JadhavLab/SpikeGadgets_OpenEphys_Drive/README.md

# SpikeGadgets_OpenEphys_Drive
A tetrode hyper drive adapted from open ephys to work with spikegadgets
