JadhavLab/SpikeGadgets_OpenEphys_Drive/Spikegadgets 256 EIB parts+screws/OpenEphysMap.pdf

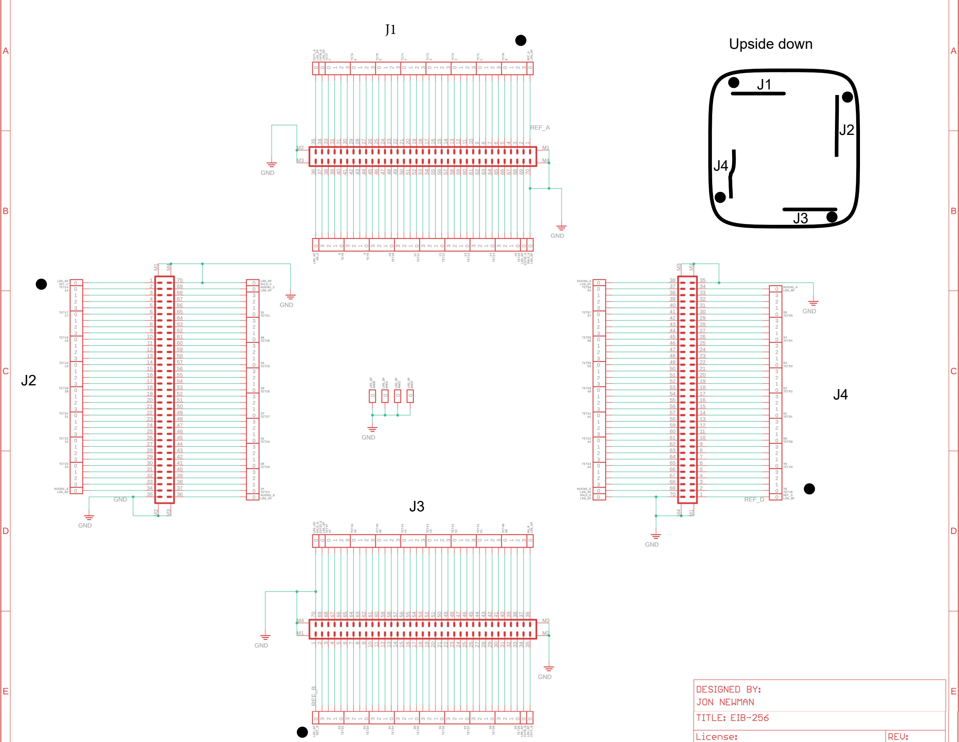
[picture p1: page 1]

J1

J4

J2

J3

Upside down

J1

J2

J3

J4
