JadhavLab/SpikeGadgets_OpenEphys_Drive/Spikegadgets 256 EIB parts+screws/256ch NOT channels.PNG

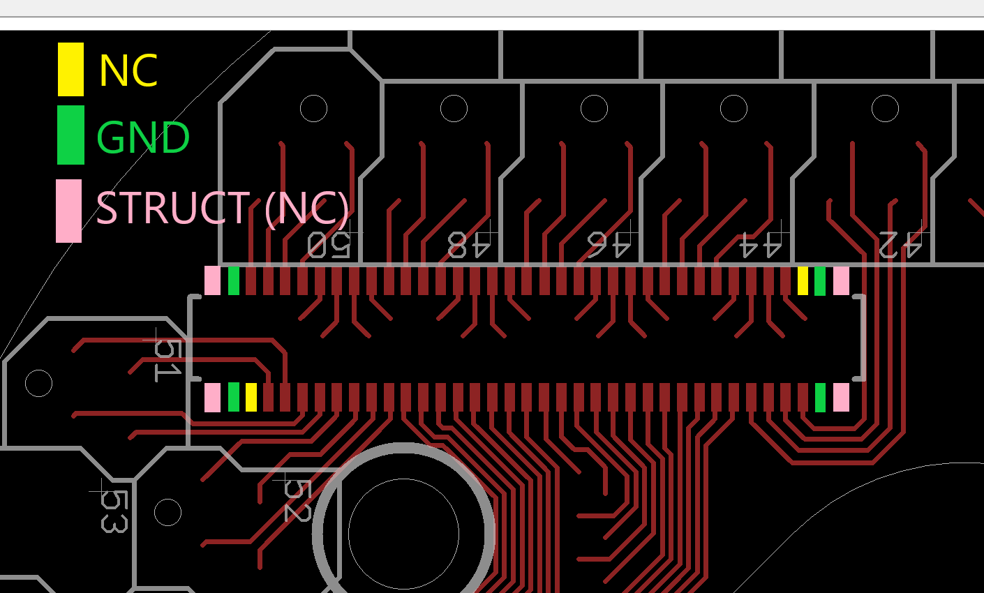
Spikegadgets 256 EIB parts+screws/256ch NOT channels.PNG
