JadhavLab/SpikeGadgets_OpenEphys_Drive/Spikegadgets 256 EIB parts+screws/OE drive pads.png

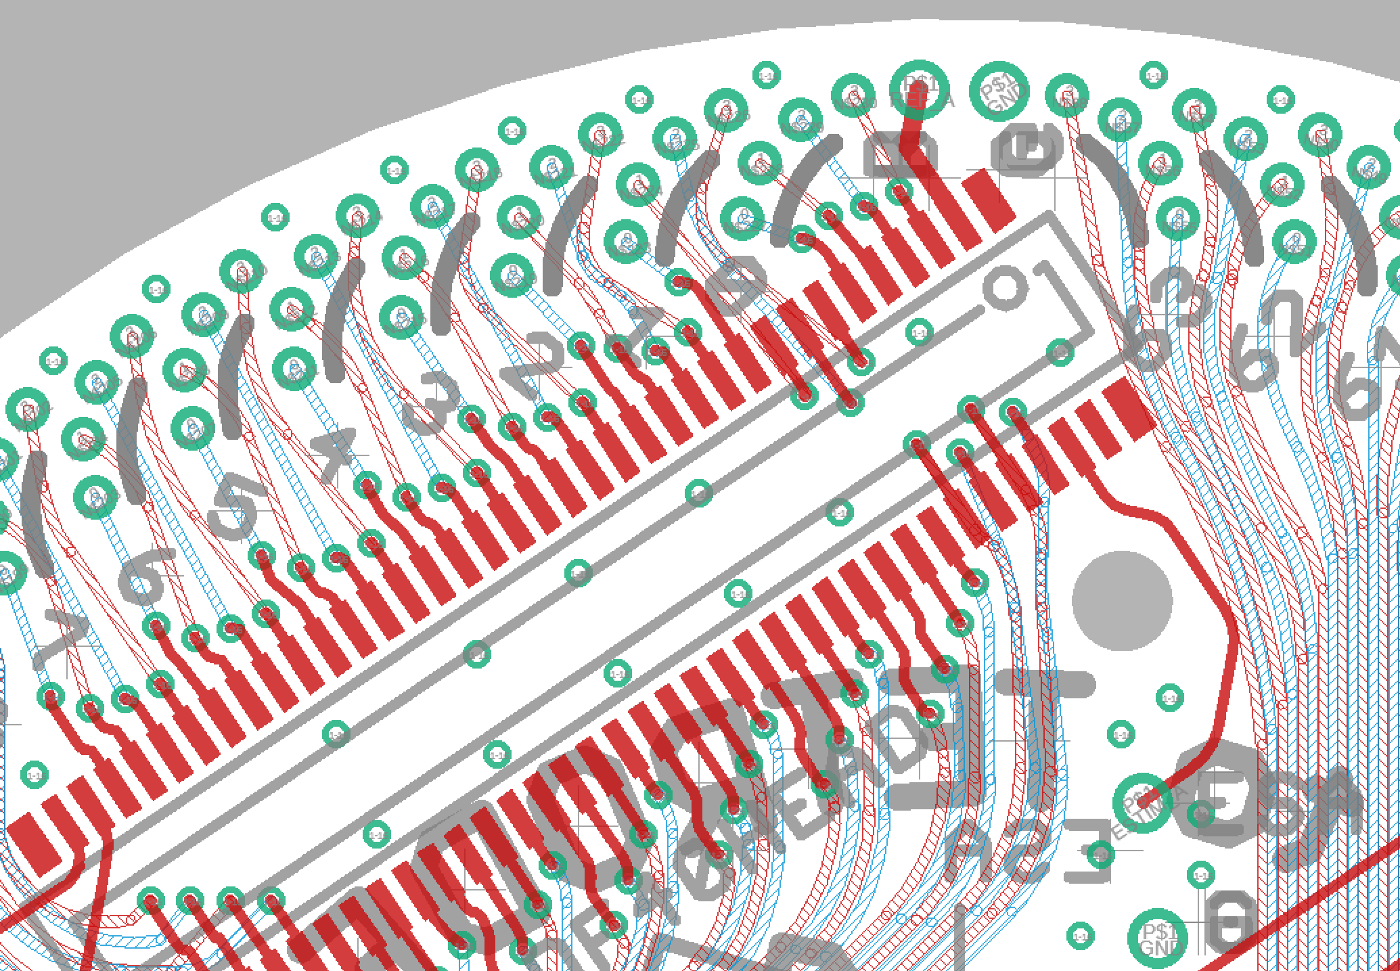
Spikegadgets 256 EIB parts+screws/OE drive pads.png
