JadhavLab/SpikeGadgets_OpenEphys_Drive/Spikegadgets 256 EIB parts+screws/OpenEphysMap.tif

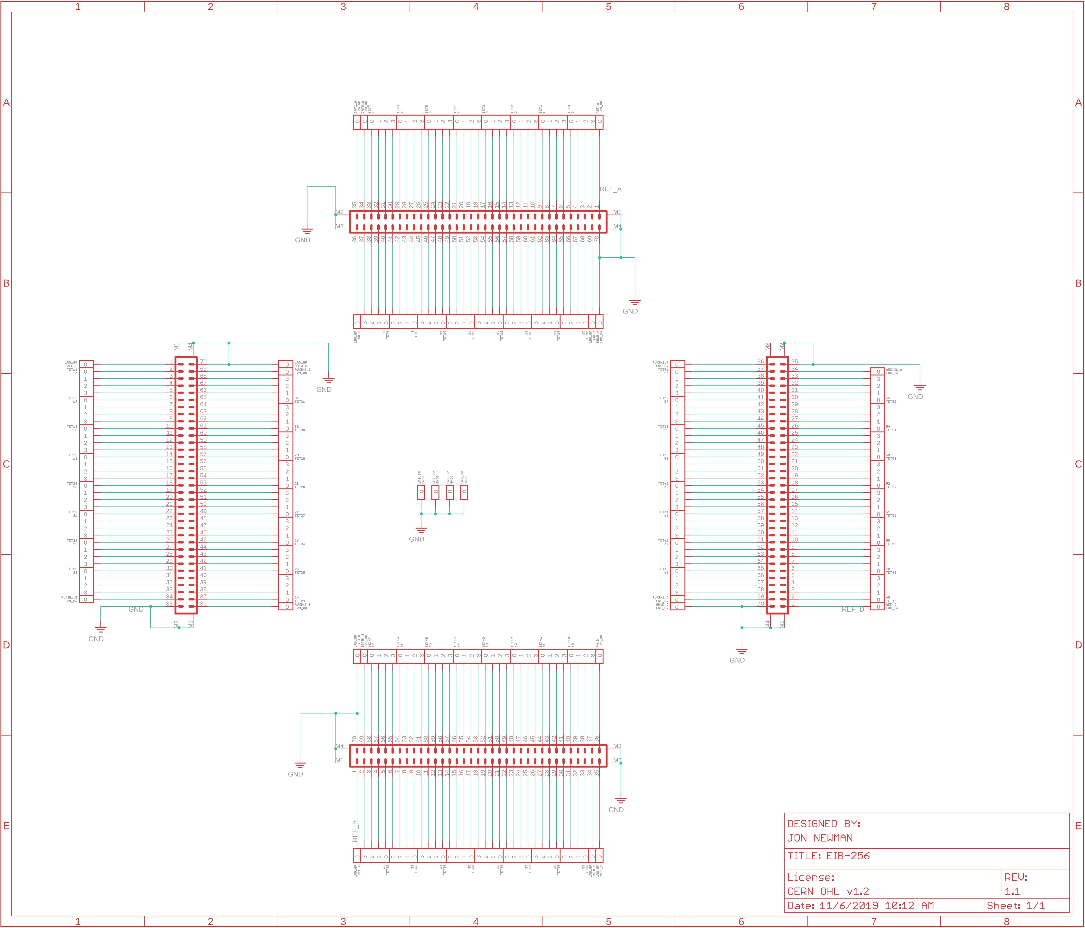
Spikegadgets 256 EIB parts+screws/OpenEphysMap.tif
