JadhavLab/SpikeGadgets_OpenEphys_Drive/Spikegadgets 256 EIB parts+screws/SpikeGadgets256.jpg

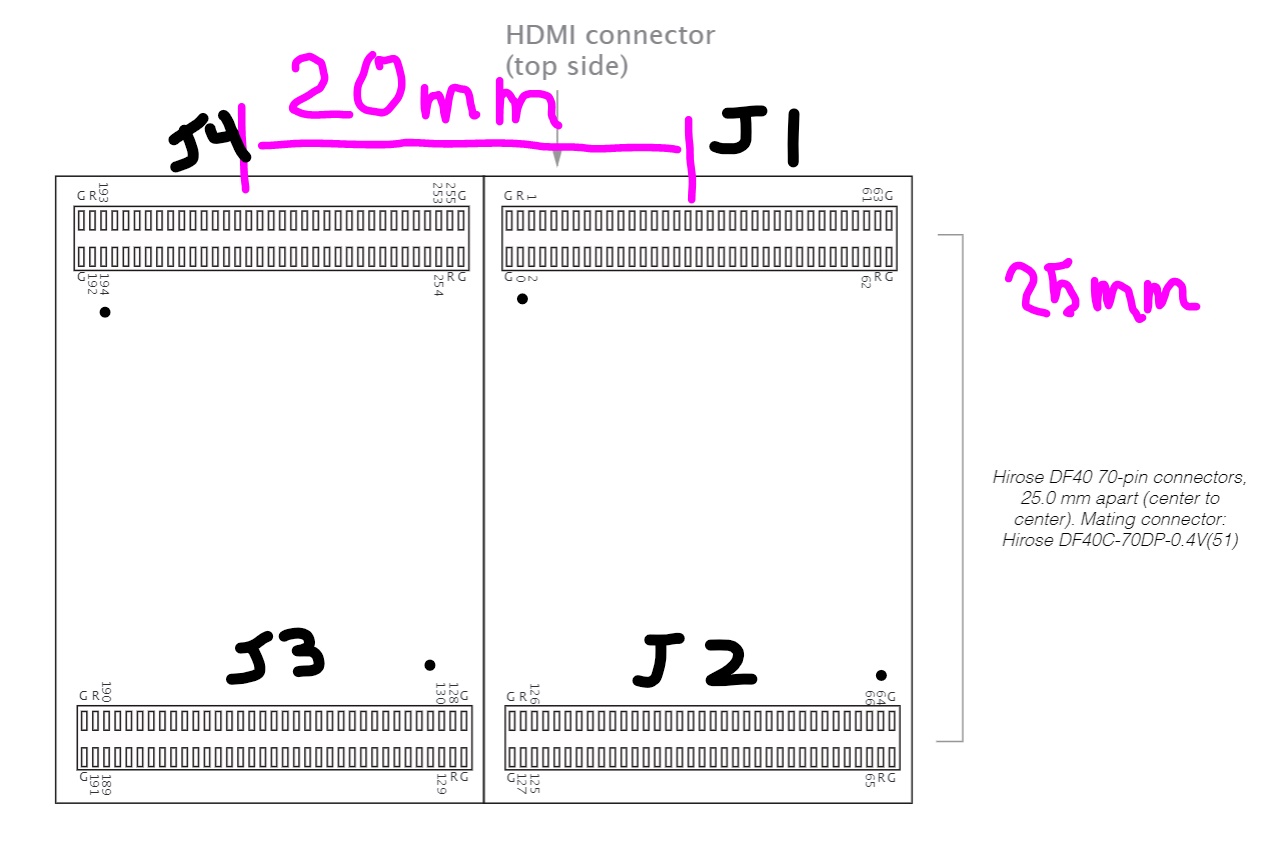
Spikegadgets 256 EIB parts+screws/SpikeGadgets256.jpg
