JadhavLab/SpikeGadgets_OpenEphys_Drive/SG_Drive_Jig_Assembly/Drive/Drive_body_v4.SLDPRT

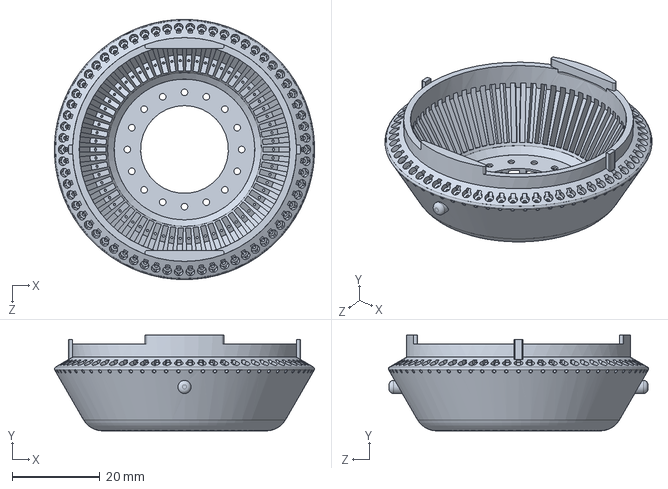
[picture p6: CAD file, 2020-12-02]
SG_Drive_Jig_Assembly/Drive/Drive_body_v4.SLDPRT
59.2 x 21.8 x 59.3 mm
