JadhavLab/SpikeGadgets_OpenEphys_Drive/SG_Drive_Jig_Assembly/Jig/2020_12_14_stls/M2_Hex_Knob.STL

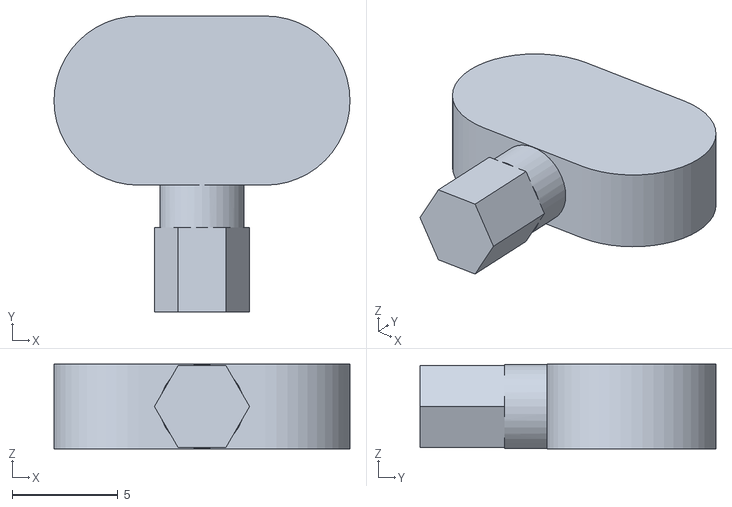
[picture p7: CAD file, 2020-12-14]
SG_Drive_Jig_Assembly/Jig/2020_12_14_stls/M2_Hex_Knob.STL
14.0 x 14.0 x 4.00
