JadhavLab/SpikeGadgets_OpenEphys_Drive/SG_Drive_Jig_Assembly/Jig/eib_holder_top.SLDPRT

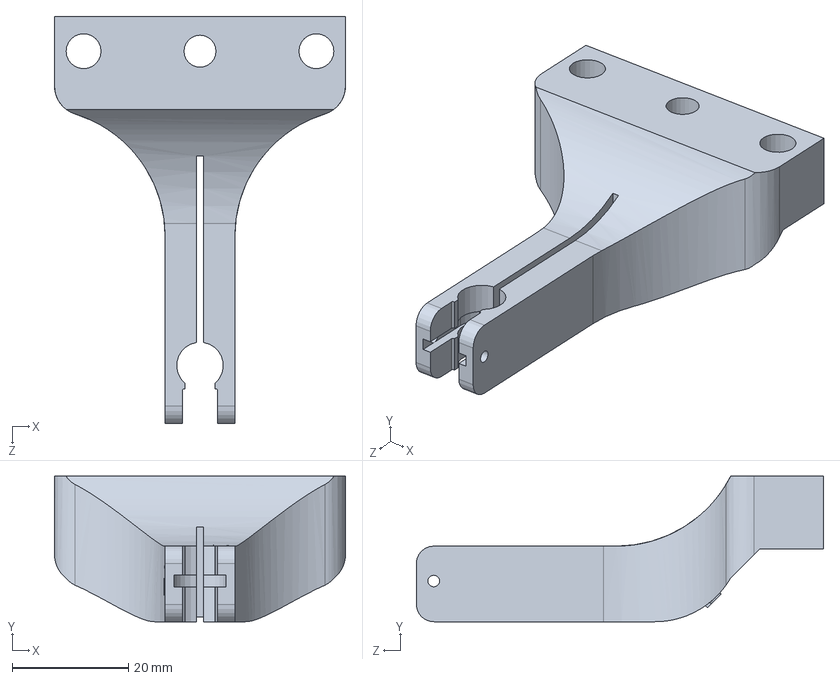
[picture p8: CAD file, 2020-12-02]
SG_Drive_Jig_Assembly/Jig/eib_holder_top.SLDPRT
50.0 x 25.0 x 70.0 mm
