JadhavLab/SpikeGadgets_OpenEphys_Drive/SG_Drive_Jig_Assembly/Jig/Standard Parts ie Resources/SpikeGadgets_256_EIB.SLDPRT

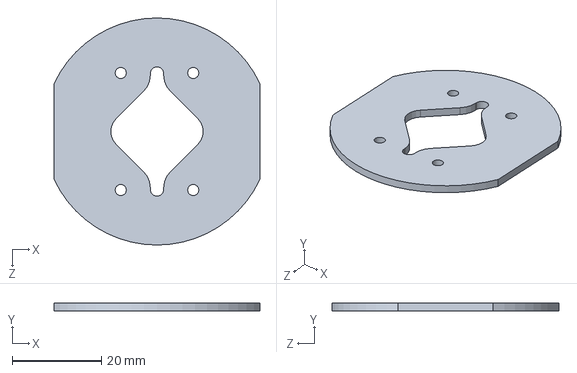
[picture p9: CAD file, 2020-12-02]
SG_Drive_Jig_Assembly/Jig/Standard Parts ie Resources/SpikeGadgets_256_EIB.SLDPRT
46.2 x 1.75 x 50.9 mm
