JadhavLab/SpikeGadgets_OpenEphys_Drive/Tetrode Spooler/Spool.SLDPRT

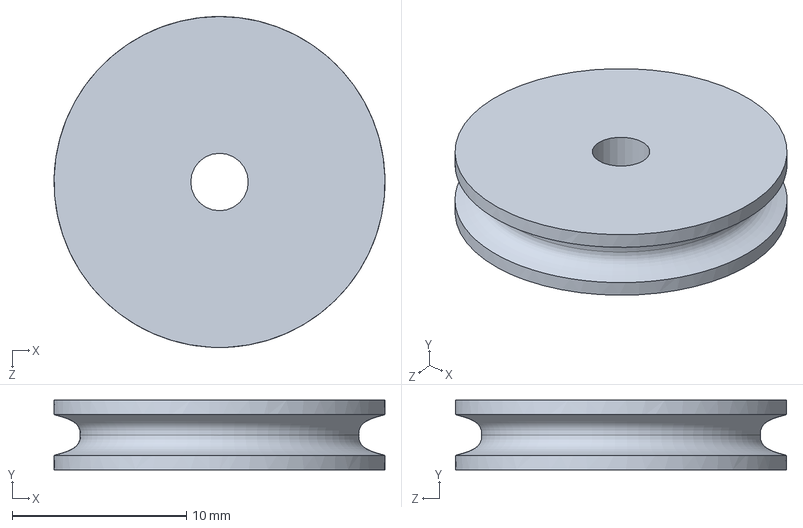
[picture p10: CAD file, 2020-12-02]
Tetrode Spooler/Spool.SLDPRT
19.0 x 4.00 x 19.0 mm
