JadhavLab/SpikeGadgets_OpenEphys_Drive/SG_Drive_Jig_Assembly/Drive/drive_shuttle_JB_pallet-grey-v2.SLDPRT

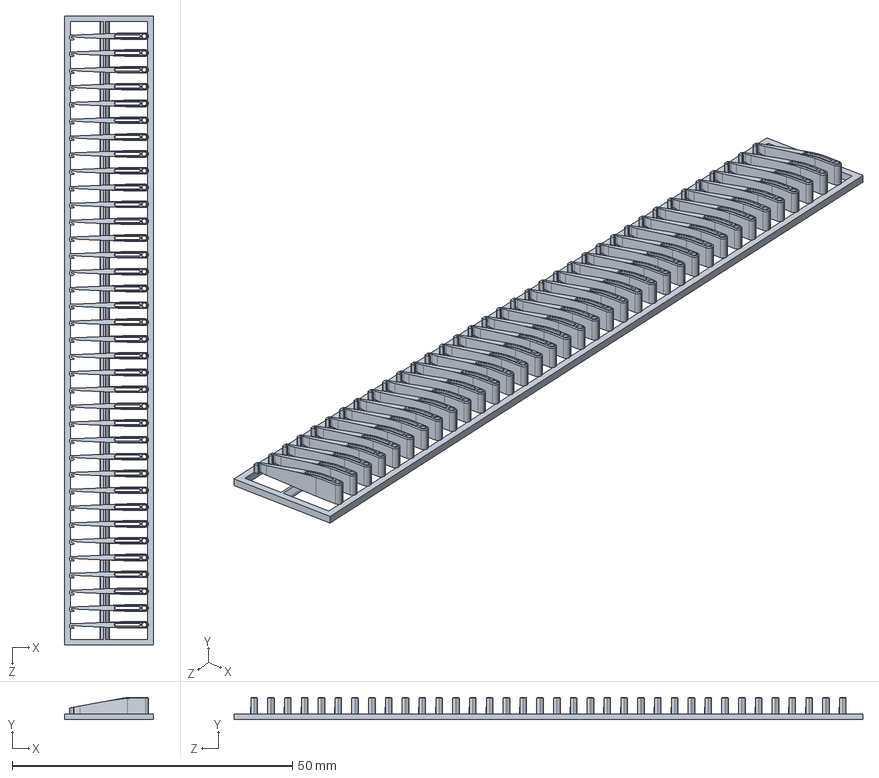
[picture p11: CAD file, 2020-12-02]
SG_Drive_Jig_Assembly/Drive/drive_shuttle_JB_pallet-grey-v2.SLDPRT
15.8 x 4.00 x 112.2 mm
