JadhavLab/SpikeGadgets_OpenEphys_Drive/SG_Drive_Jig_Assembly/Guides/drive-guide-HPC-PFC_v2.1.SLDPRT

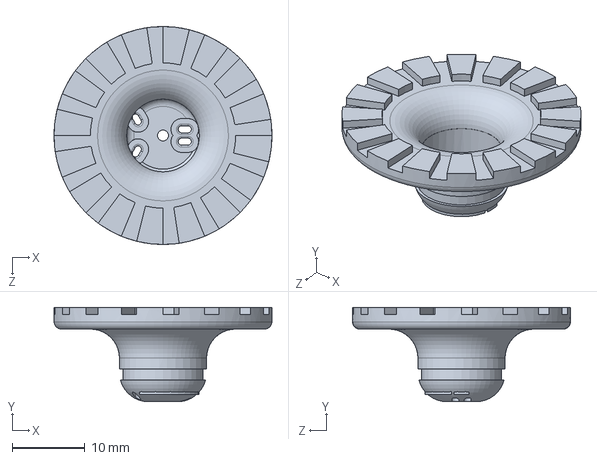
[picture p12: CAD file, 2020-12-02]
SG_Drive_Jig_Assembly/Guides/drive-guide-HPC-PFC_v2.1.SLDPRT
30.0 x 13.0 x 30.0 mm
