JadhavLab/SpikeGadgets_OpenEphys_Drive/SG_Drive_Jig_Assembly/Jig/2020_12_14_stls/drive_holder_inner.STL

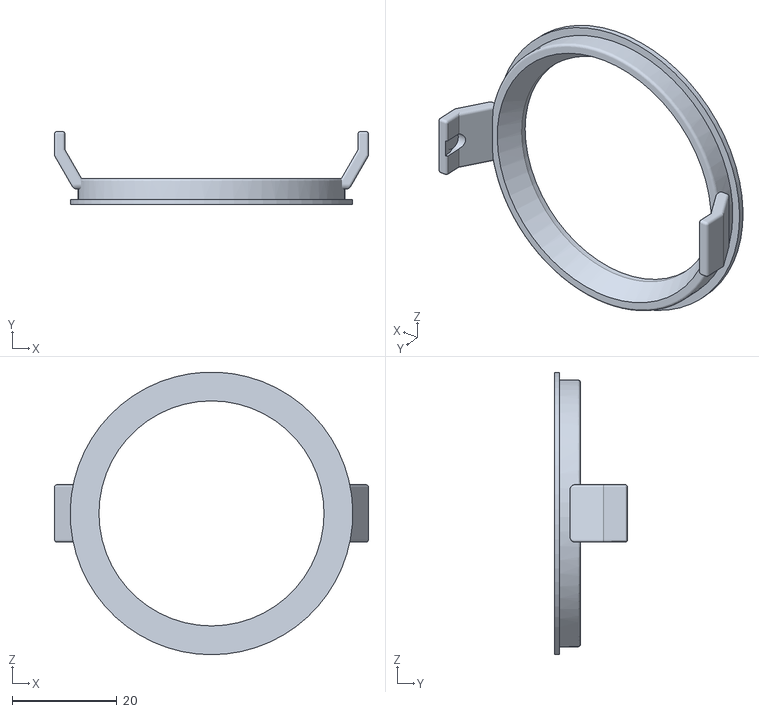
[picture p13: CAD file, 2020-12-14]
SG_Drive_Jig_Assembly/Jig/2020_12_14_stls/drive_holder_inner.STL
60.0 x 14.0 x 54.0
