JadhavLab/SpikeGadgets_OpenEphys_Drive/SG_Drive_Jig_Assembly/Jig/drive_holder_outer_ring.SLDPRT

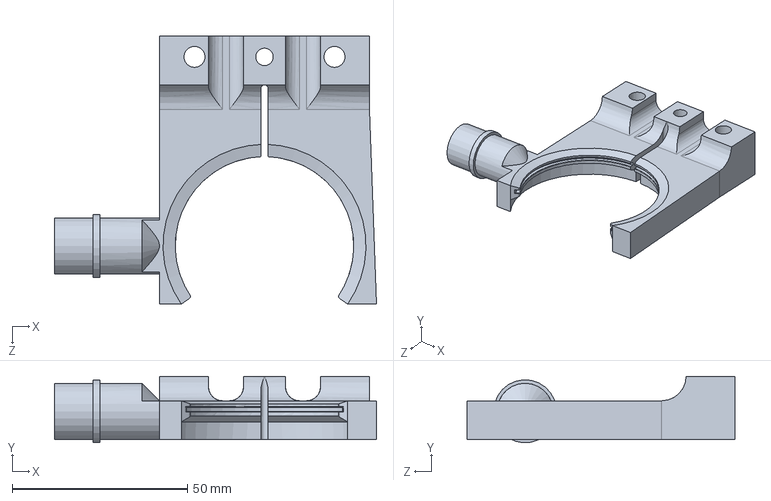
[picture p14: CAD file, 2020-12-02]
SG_Drive_Jig_Assembly/Jig/drive_holder_outer_ring.SLDPRT
92.0 x 19.0 x 76.6 mm
