JadhavLab/SpikeGadgets_OpenEphys_Drive/SG_Drive_Jig_Assembly/Jig/Standard Parts ie Resources/80mm_6mm_dowel.SLDPRT

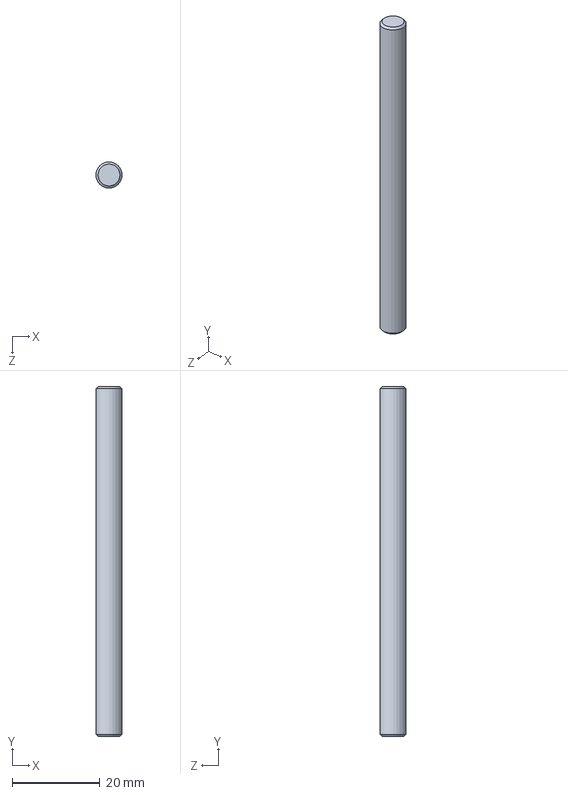
[picture p15: CAD file, 2020-12-02]
SG_Drive_Jig_Assembly/Jig/Standard Parts ie Resources/80mm_6mm_dowel.SLDPRT
6.00 x 80.0 x 6.00 mm
