JadhavLab/SpikeGadgets_OpenEphys_Drive/Tetrode Spooler/Spool_extendedSize.SLDPRT

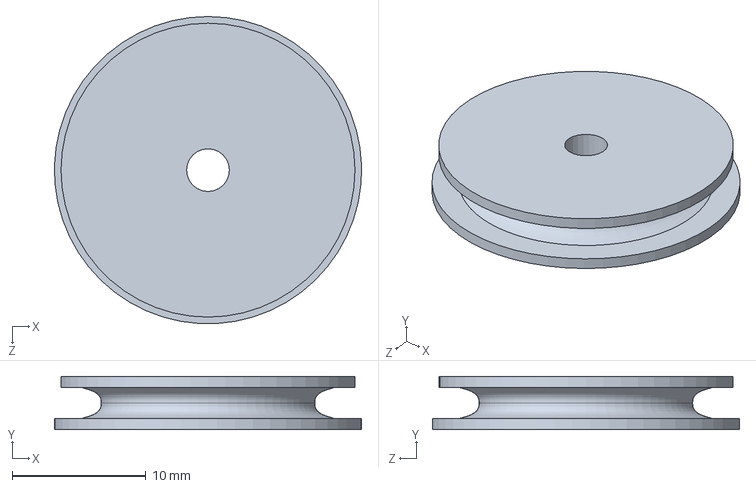
[picture p16: CAD file, 2020-12-02]
Tetrode Spooler/Spool_extendedSize.SLDPRT
23.0 x 4.00 x 23.0 mm
