JadhavLab/SpikeGadgets_OpenEphys_Drive/SG_Drive_Jig_Assembly/Jig/2020_12_14_stls/base.STL

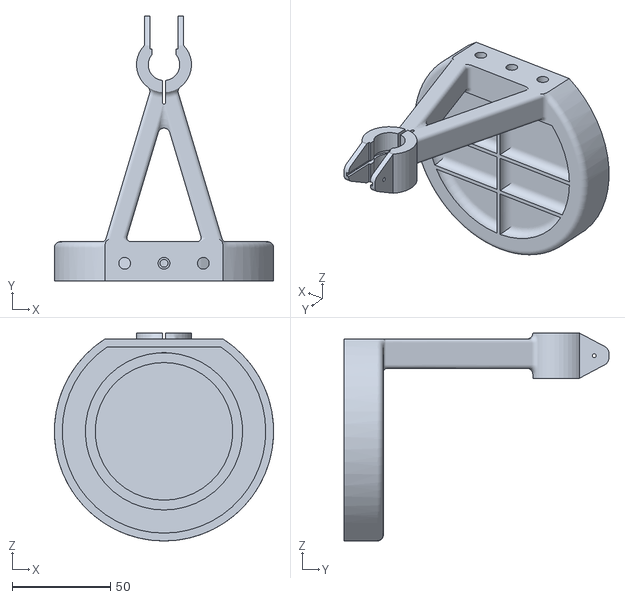
[picture p17: CAD file, 2020-12-14]
SG_Drive_Jig_Assembly/Jig/2020_12_14_stls/base.STL
111.5 x 134.8 x 105.8
