JadhavLab/SpikeGadgets_OpenEphys_Drive/SG_Drive_Jig_Assembly/Jig/EIB_Holder_bottom.SLDPRT

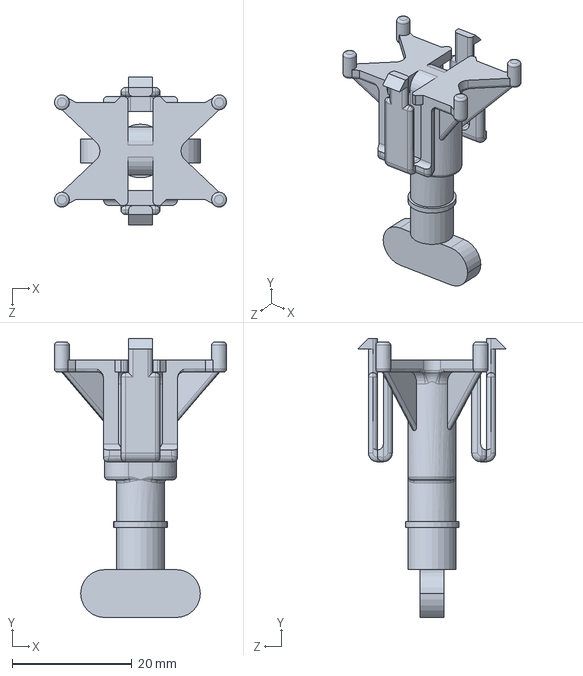
[picture p18: CAD file, 2020-12-02]
SG_Drive_Jig_Assembly/Jig/EIB_Holder_bottom.SLDPRT
28.8 x 46.6 x 24.8 mm
