JadhavLab/SpikeGadgets_OpenEphys_Drive/Tetrode Spooler/Spool_regularSize.STL

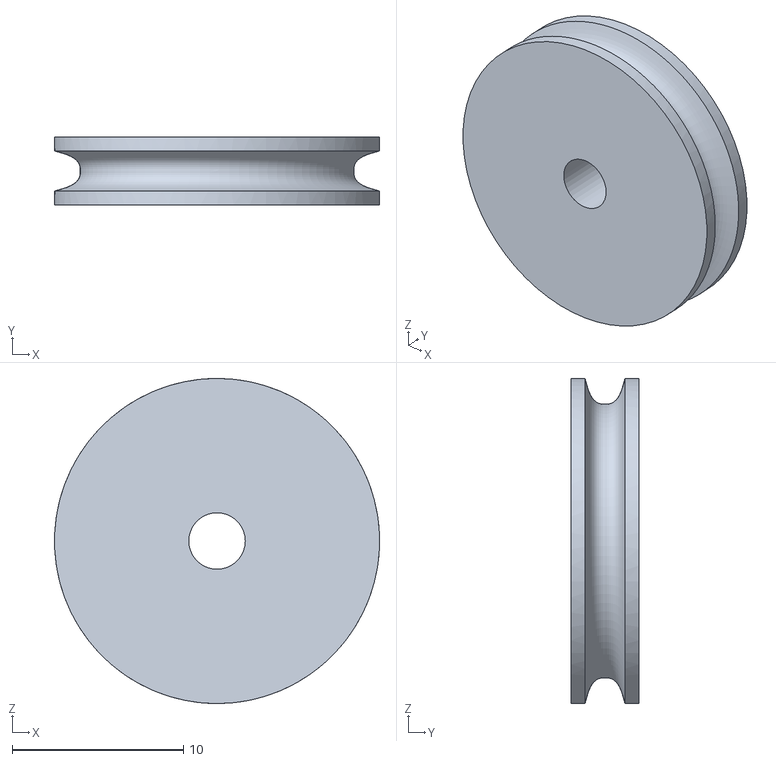
[picture p19: CAD file, 2020-12-02]
Tetrode Spooler/Spool_regularSize.STL
19.0 x 4.00 x 19.0
