JadhavLab/SpikeGadgets_OpenEphys_Drive/(list of files, cad)

Other CAD files:
SG_Drive_Jig_Assembly/Jig/Standard Parts ie Resources/M2_Hex_Knob.SLDPRT
SG_Drive_Jig_Assembly/Jig/2020_12_14_stls/drive_holder_outer_ring.STL
SG_Drive_Jig_Assembly/Jig/drive_holder_inner.SLDPRT
SG_Drive_Jig_Assembly/Jig/2020_12_14_stls/EIB_Holder_bottom.STL
SG_Drive_Jig_Assembly/Jig/base.SLDPRT
SG_Drive_Jig_Assembly/Jig/2020_12_14_stls/eib_holder_top.STL
SG_Drive_Jig_Assembly/Drive/Old Drive and shuttle versions/drive_body_v3.SLDPRT
SG_Drive_Jig_Assembly/Drive/Old Drive and shuttle versions/drive_shuttle_JB_pallet-grey.SLDPRT
SG_Drive_Jig_Assembly/Drive/Old Drive and shuttle versions/rat_drive_shuttle_JB_pallet.SLDPRT
SG_Drive_Jig_Assembly/Guides/drive-guide-HPC-PFC_v2.SLDPRT
SG_Drive_Jig_Assembly/Jig/Standard Parts ie Resources/91290A201_BLACK-OXIDE CLASS 12.9 SOCKET HEAD CAP SCREW.SLDPRT
SG_Drive_Jig_Assembly/Jig/Standard Parts ie Resources/91292A835_TYPE 18-8 SS SOCKET HEAD CAP SCREW.SLDPRT
SG_Drive_Jig_Assembly/Jig/Standard Parts ie Resources/Slanted-threaded-sholder screw.SLDPRT
Tetrode Spooler/Spool_extendedSize.STL
