JadhavLab/SpikeGadgets_OpenEphys_Drive/Spikegadgets 256 EIB parts+screws/df40-70dp-0.4v(51) plug.pdf

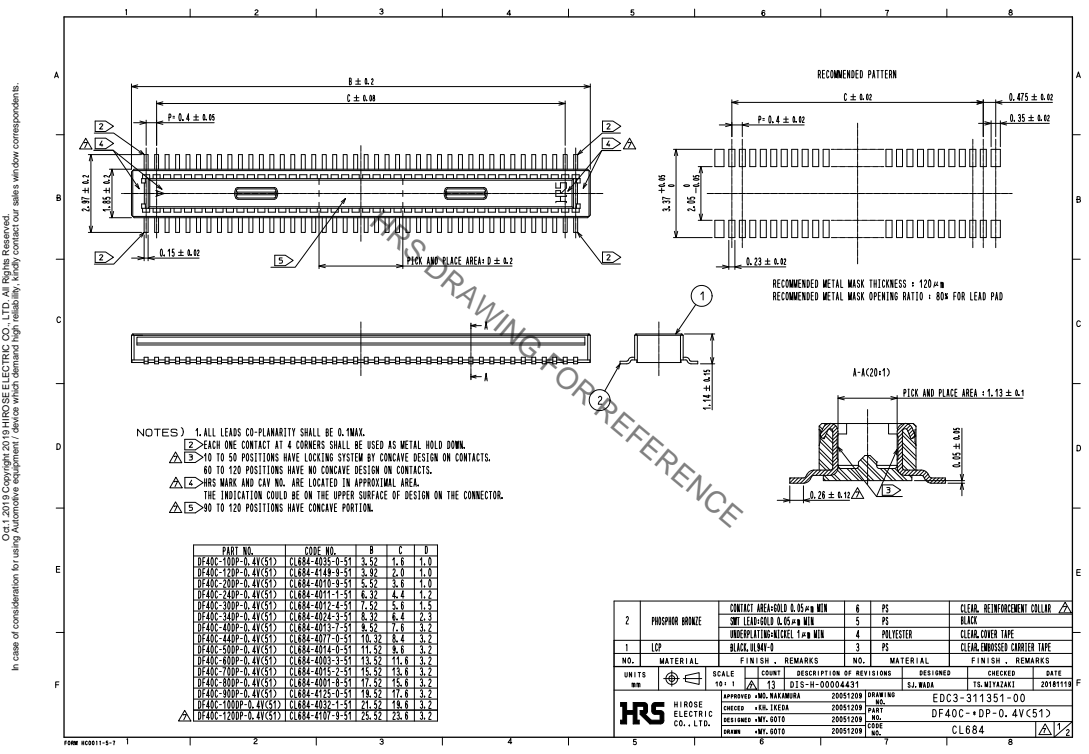
[picture p20: page 1]

HRS DRAWING FOR REFERENCE

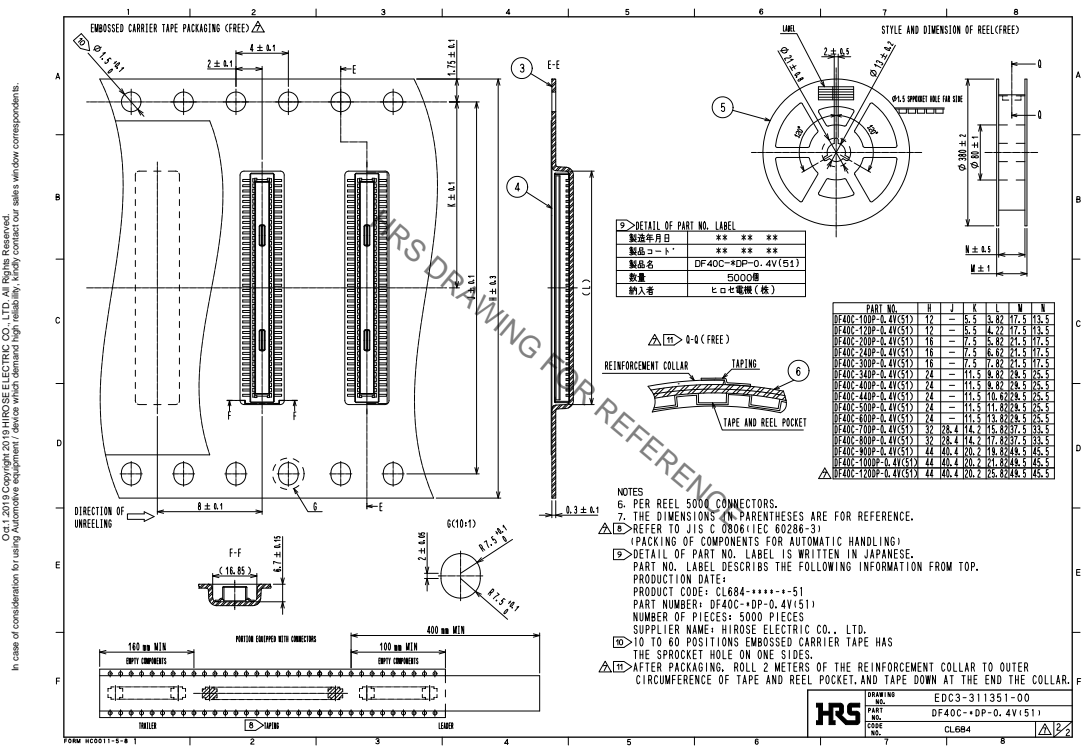
[picture p21: page 2]

HRS DRAWING FOR REFERENCE
