JadhavLab/SpikeGadgets_OpenEphys_Drive/Spikegadgets 256 EIB parts+screws/df40-70ds-0.4v(51) receiver.pdf

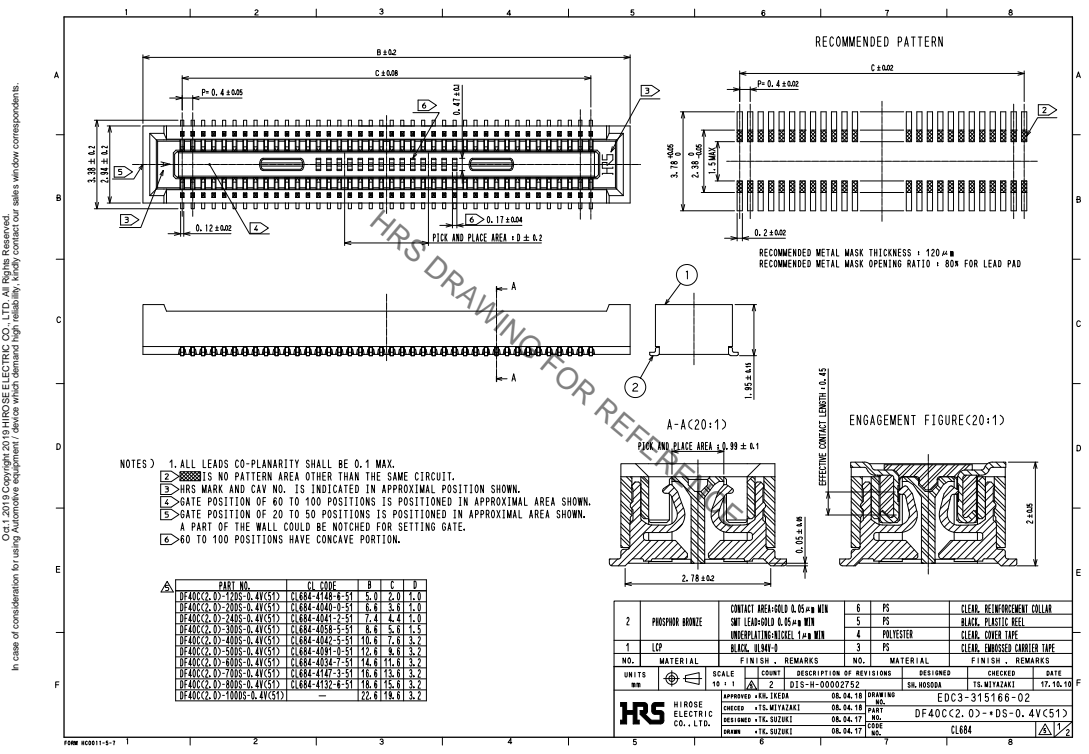
[picture p22: page 1]

HRS DRAWING FOR REFERENCE

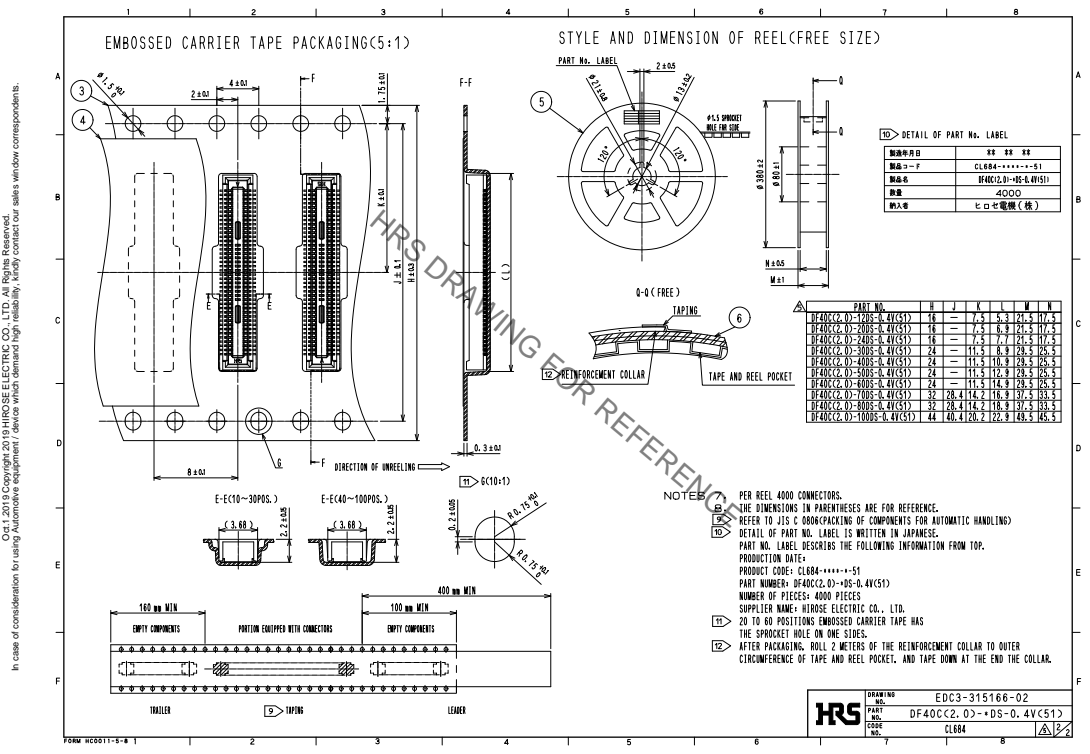
[picture p23: page 2]

HRS DRAWING FOR REFERENCE
