JadhavLab/SpikeGadgets_OpenEphys_Drive/(commit log)

2020-12-02 first the readmes
    these are all the annotation docs
    [Bill of Parts.xlsx]
2020-12-02 EIB parts and scres only
    adding just the eib stuff
    [Antrin Quote 2k screws.xls]
2020-12-02 Tetrode spooler stuff
    3d printed pars for the tetrode spools, need to add code to this later
    [Spool.SLDPRT, Spool_extendedSize.SLDPRT, Spool_extendedSize.STL, Spool_regularSize.STL]
2020-12-02 This has all the parts for the drive
    There may be files too large in here...
    [80mm_6mm_dowel.SLDPRT, 91290A201_BLACK-OXIDE CLASS 12.9 SOCKET HEAD CAP SCREW.SLDPRT, 91292A835_TYPE 18-8 SS SOCKET HEAD CAP SCREW.SLDPRT, Drive_body_v4.SLDPRT, EIB_Holder_bottom.SLDPRT, EIB_Holder_bottom_v2.SLDPRT, EIB_holder_top_V2.STL, M2_Hex_Knob.SLDPRT]
2020-12-02 changed file locations
    the parent folder for the jig now has compatable parts that are the most recent version
    [80mm_6mm_dowel.SLDPRT, 91290A201_BLACK-OXIDE CLASS 12.9 SOCKET HEAD CAP SCREW.SLDPRT, 91292A835_TYPE 18-8 SS SOCKET HEAD CAP SCREW.SLDPRT, EIB_Holder_bottom.SLDPRT, EIB_Holder_bottom_v2.SLDPRT, M2_Hex_Knob.SLDPRT, SG_eib_holder_top_V3.SLDPRT, Slanted-threaded-sholder screw.SLDPRT]
2020-12-02 Create drive-holder-inner.SLDPRT
    Forgot to added the drive holde rinner. This may need some work to better latch to the drive itself
    [drive-holder-inner.SLDPRT]
2020-12-03 Clearing out parts for sequential Add
    [80mm_6mm_dowel.SLDPRT, 91290A201_BLACK-OXIDE CLASS 12.9 SOCKET HEAD CAP SCREW.SLDPRT, 91292A835_TYPE 18-8 SS SOCKET HEAD CAP SCREW.SLDPRT, EIB_Holder_bottom.SLDPRT, EIB_Holder_bottom_v2.SLDPRT, EIB_holder_top_V2.STL, M2_Hex_Knob.SLDPRT, SG_drive_body_holder_outer_ring_v3.SLDPRT]
2020-12-03 v1_Bladon Jig
    short jig, weak EIB holder, snap fittiings are tight
    [EIB_Holder_bottom.SLDPRT, base_big_rat.SLDPRT, drive-holder-inner.SLDPRT, drive_holder_outer_ring.SLDPRT, eib_holder_top.SLDPRT]
2020-12-03 v2_Bladon jig
    large base
    [base_big_rat.SLDPRT, base_big_rat.STL, drive_holder_outer_ring.SLDPRT]
2020-12-03 v3_Bladon jig
    stronger EIB holder
    [EIB_Holder_bottom.SLDPRT, EIB_holder_top.STL, eib_holder_top.SLDPRT]
2020-12-03 v3.1_Bladon jig
    wide arm - better snap fit for outer/inner EIB holders
    [drive_holder_outer_ring.SLDPRT, eib_holder_top.SLDPRT]
2020-12-03 remove old stl
    [EIB_holder_top.STL]
2020-12-03 v4 Bladon jig
    Also added resources file, fixed naming conventions
    [80mm_6mm_dowel.SLDPRT, 91290A201_BLACK-OXIDE CLASS 12.9 SOCKET HEAD CAP SCREW.SLDPRT, 91292A835_TYPE 18-8 SS SOCKET HEAD CAP SCREW.SLDPRT, M2_Hex_Knob.SLDPRT, Slanted-threaded-sholder screw.SLDPRT, base.SLDPRT, base_big_rat.STL, drive_holder_inner.SLDPRT]
2020-12-03 Spike gadgets EIB added to std parts
    [SpikeGadgets_256_EIB.SLDPRT]
2020-12-03 demonstrating gitflow
    [drive_holder_inner - Copy.SLDPRT]
2020-12-03 Renaming spikegadg EIB folder for clarity
    [Antrin Quote 2k screws.xls]
2020-12-03 undoing my demo
    [drive_holder_inner - Copy.SLDPRT]
2020-12-08 Update Bill of Parts.xlsx
    McMaster carr updated their catalog, so I updated some part numbers
    [Bill of Parts.xlsx]
2020-12-10 updating bill of parts - tough not rigid plastic for jig parts
    [Bill of Parts.xlsx]
2020-12-14 Added stls and preform print for jig
    [EIB_Holder_bottom.STL, M2_Hex_Knob.STL, base.STL, drive_holder_inner.STL, drive_holder_outer_ring.STL, eib_holder_top.STL]
2020-12-16 added gcode for jig bottom print on extrusion printer
2021-02-01 removed quotes
    needed to remove quotes to not piss off vendors
    [Antrin Quote 2k screws.xls]
